kaibeckmann/EchtzeitHat/EchtzeitHat_Bestückungsliste.ods

Step | Part | Value | Device | Package
SMD 1 | C2 | 0.1uF | 1.0UF-25V-+80/-20(0805) | 0806-CAP
 | C3 | 0.1uF | 1.0UF-25V-+80/-20(0805) | 0807-CAP
 | C4 | 0.1uF | 1.0UF-25V-+80/-20(0805) | 0808-CAP
 | C5 | 0.1uF | 1.0UF-25V-+80/-20(0805) | 0809-CAP
 | C6 | 0.1uF | 1.0UF-25V-+80/-20(0805) | 0810-CAP
 | C9 | 0.1uF | 1.0UF-25V-+80/-20(0805) | 0813-CAP
 | C11 | 0.1uF | 1.0UF-25V-+80/-20(0805) | 0815-CAP
 | C12 | 0.1uF | 1.0UF-25V-+80/-20(0805) | 0816-CAP
 | C10 | 10uF | 1.0UF-25V-+80/-20(0805) | 0814-CAP
 | C7 | 47pF | 1.0UF-25V-+80/-20(0805) | 0811-CAP
 | C8 | 47pF | 1.0UF-25V-+80/-20(0805) | 0812-CAP
 | C1 | 4.7uF | 1.0UF-25V-+80/-20(0805) | 0805-CAP
SMD 2 | R1 | 22 | 0.22OHM-1/4W-1%(0805) | 805
 | R2 | 22 | 0.22OHM-1/4W-1%(0805) | 805
 | R5 | 1k | 0.22OHM-1/4W-1%(0805) | 805
 | R3 | 4.7k | 0.22OHM-1/4W-1%(0805) | 805
 | R12 | 4.7k | 0.22OHM-1/4W-1%(0805) | 805
 | R4 | 10k | 0.22OHM-1/4W-1%(0805) | 805
 | R7 | 10k | 0.22OHM-1/4W-1%(0805) | 805
 | R9 | 10k | 0.22OHM-1/4W-1%(0805) | 805
 | R8 | 10k | 0.22OHM-1/4W-1%(0805) | 805
 | R11 | 10k | 0.22OHM-1/4W-1%(0805) | 805
 | R15 | 10k | 0.22OHM-1/4W-1%(0805) | 805
 | R16 | 10k | 0.22OHM-1/4W-1%(0805) | 805
 | R17 | 10k | 0.22OHM-1/4W-1%(0805) | 805
 | R18 | 10k | 0.22OHM-1/4W-1%(0805) | 805
 | R19 | 10k | 0.22OHM-1/4W-1%(0805) | 805
 | R6 | 1.5k | 0.22OHM-1/4W-1%(0805) | 805
 | R10 | 1.5k | 0.22OHM-1/4W-1%(0805) | 805
 | R13 | 1.5k | 0.22OHM-1/4W-1%(0805) | 805
 | R14 | 1.5k | 0.22OHM-1/4W-1%(0805) | 805
SMD 3 | LED1 | green | LEDCHIPLED_0805 | CHIPLED_0805
 | LED2 | green | LEDCHIPLED_0805 | CHIPLED_0805
 | LED3 | green | LEDCHIPLED_0805 | CHIPLED_0805
 | LED4 | green | LEDCHIPLED_0805 | CHIPLED_0805
SMD 4 | Q1 | L2N7002LT1G | MOSFET-NREFLOW | SOT23
 | Q2 | L2N7002LT1G | MOSFET-NREFLOW | SOT23
 | Q3 | L2N7002LT1G | MOSFET-NREFLOW | SOT23
 | Q4 | L2N7002LT1G | MOSFET-NREFLOW | SOT23
 | Q5 | L2N7002LT1G | MOSFET-NREFLOW | SOT23
SMD5 | U1 | FT230XS-R | FT230XS-R | SSOP16-0.635-5X4MM
 | IC2 | TB6612FNG | TB6612FNG | SSOP24
 | IC3 | ATTINY10 | ATTINY10 | SOT23-6
 | CON1 | MICRO-USB | Molex Micro-USB 47589-0001 | 47589-0001
TH 1 | X1 | RasbPi-Header | RASPI_BOARD_B+#_H | RASPI_BOARD_B+HAT
TH 2 | SW1 | TACTILE-SWITCH-PTH | TACTILE-SWITCH-PTH | TAC-SWITCH-PTH
 | SW2 | TACTILE-SWITCH-PTH | TACTILE-SWITCH-PTH | TAC-SWITCH-PTH
TH 3 | J1 | UART | CONN_03LOCK | 1X03_LOCK
 | J3 |  | CONN_03LOCK | 1X03_LOCK
 | J4 |  | CONN_03LOCK | 1X03_LOCK
 | J6 |  | CONN_03LOCK | 1X03_LOCK
 | J7 |  | CONN_03LOCK | 1X03_LOCK
 | J8 |  | M03LOCK | 1X03_LOCK
 | J11 |  | CONN_03LOCK | 1X03_LOCK
 | J12 |  | CONN_03LOCK | 1X03_LOCK
 | J13 | TPI | CONN_05LOCK | 1X05_LOCK
 | J14 | Voltage Out | M04LOCK | 1X04_LOCK
TH 4 | J9 |  | M023.5MM_LOCK | SCREWTERMINAL-3.5MM
 | J10 |  | M023.5MM_LOCK | SCREWTERMINAL-3.5MM
TH 5 | J5 | FAN 4-pin Header | MOLEX_47053-1000 | MOLEX_47053-1000_0
TH 6 | IC1 | VREG-OKI-78SR-5.0 | VREG-OKI-78SR-5.0/1.5-W36H | OKI-78SR-H
TH 7 | J2 | PJ-102A | PJ-102A | CUI_PJ-102A
TH 8 | VR1 | 10k | POTENTIOMETER-PTH-9MM | POT-PTH-ALPS-KIT
