kaibeckmann/EchtzeitHat/schematic/EchtzeitHat_sch.pdf

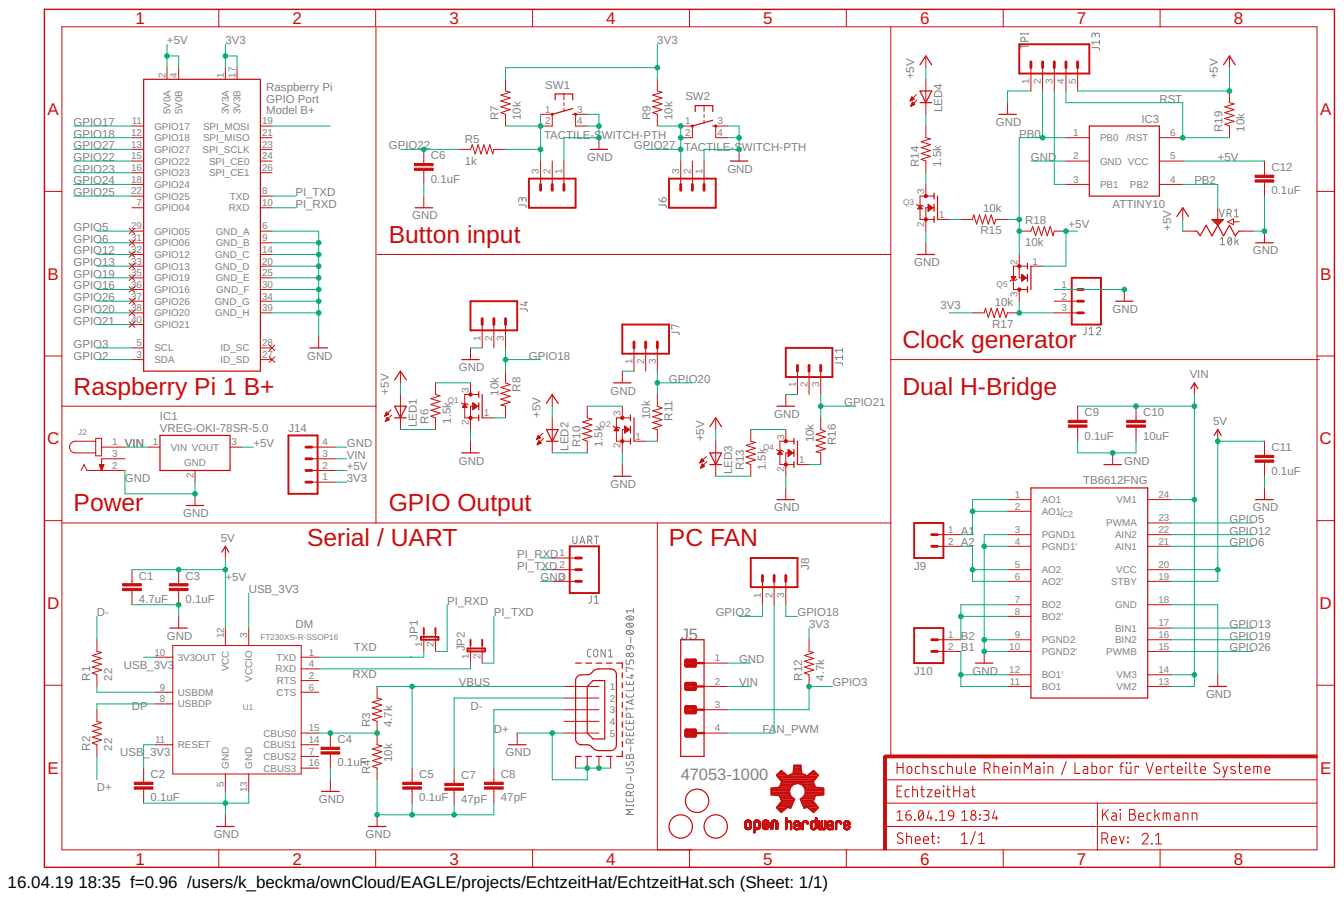
[picture p1: page 1]

17 GND

16 BIN1 | GPIO19
15 BIN2 | GPIO26
14 PWMB

16.04.19 18:35 f=0.96 /users/k_beckma/ownCloud/EAGLE/projects/EchtzeitHat/EchtzeitHat.sch (Sheet: 1/1)
