kaibeckmann/EchtzeitHat/schematic/EchtzeitHat_brd.pdf

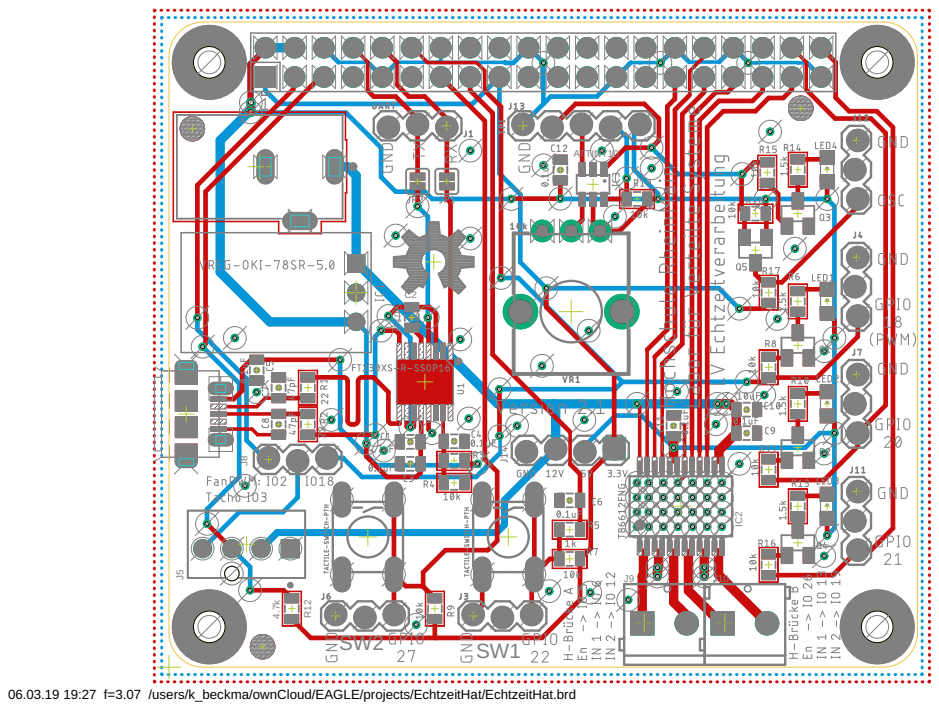
[picture p2: page 1]

06.03.19 19:27 f=3.07 /users/k_beckma/ownCloud/EAGLE/projects/EchtzeitHat/EchtzeitHat.brd
