kaibeckmann/EchtzeitHat/schematic/EchtzeitHat.brd

## EAGLE design schematic/EchtzeitHat.brd (2020-04-17)

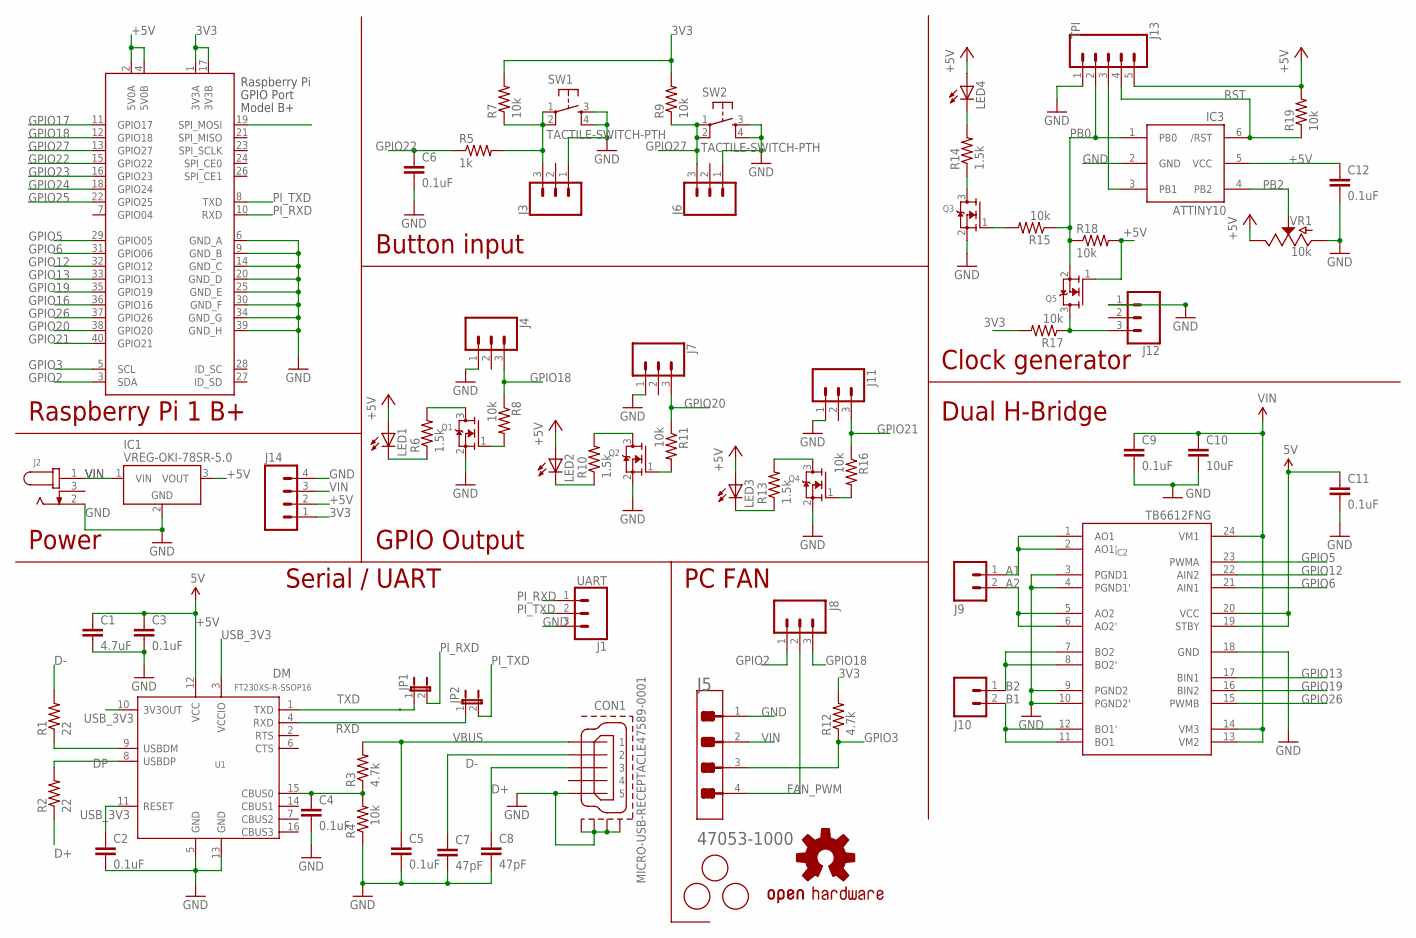
[picture p3: schematic EchtzeitHat.sch]

Parts:
C1: 4.7uF; 0805-CAP
C2, C3, C4, C5, C6, C9, C11, C12: 0.1uF; 0805-CAP
C7, C8: 47pF; 0805-CAP
C10: 10uF; 0805-CAP
CON1: MICRO-USB-RECEPTACLE47589-0001; 47589-0001
FI1, FI2, FI3: FIDUCIAL; FIDUCIAL_1MM
IC1: VREG-OKI-78SR-5.0; OKI-78SR-H
IC2: TB6612FNG; SSOP24
IC3: ATTINY10; SOT23-6
J1: UART; 1X03_LOCK
J2: PJ-102A; CUI_PJ-102A
J3, J4, J6, J7, J11, J12: CONN_03LOCK; 1X03_LOCK
J5: MOLEX_47053-1000MOLEX_47053-1000_0_0; MOLEX_47053-1000_0
J8: M03LOCK; 1X03_LOCK
J9, J10: M023.5MM_LOCK; SCREWTERMINAL-3.5MM-2_LOCK
J13: TPI; 1X05_LOCK
J14: M04LOCK; 1X04_LOCK
JP1, JP2: JUMPER-2SMD-NC; SJ_2S
LED1, LED2, LED3, LED4: LEDCHIPLED_0805; CHIPLED_0805
LOGO1: OSHW-LOGOL; OSHW-LOGO-L
Q1, Q2, Q3, Q4, Q5: MOSFET-NREFLOW; SOT23
R1, R2: 22; 0805
R3, R12: 4.7k; 0805
R4, R7, R8, R9, R11, R15, R16, R17, R18, R19: 10k; 0805
R5: 1k; 0805
R6, R10, R13, R14: 1.5k; 0805
SW1, SW2: TACTILE-SWITCH-PTH; TAC-SWITCH-PTH
U1: FT230XS-R-SSOP16; SSOP16-0.635-5X4MM
VR1: 10k; POT-PTH-ALPS-KIT
X1: RASPI_BOARD_B+#_H; RASPI_BOARD_B+HAT

Connections:
3V3: J14.1, R7.2, R9.2, R12.2, R17.2, X1.1 (3V3A), X1.17 (3V3B)
+5V: C1.1, C3.1, C11.1, C12.1, IC1.3 (VOUT), IC2.19 (STBY), IC2.20 (VCC), IC3.5 (VCC), J13.5, J14.2, LED1.A, LED2.A, LED3.A, LED4.A, Q5.1 (G), R18.2, R19.2, U1.12 (VCC), VR1.P$1 (E), X1.2 (5V0A), X1.4 (5V0B)
A1: IC2.1 (AO1), IC2.2 (AO1'), J9.1
A2: IC2.5 (AO2), IC2.6 (AO2'), J9.2
B1: IC2.11 (BO1), IC2.12 (BO1'), J10.2
B2: IC2.7 (BO2), IC2.8 (BO2'), J10.1
CBUS: C4.1, R3.1, R4.2, U1.15 (CBUS0)
D+: C8.1, CON1.3, R2.1
D-: C7.1, CON1.2, R1.2
DM: R1.1, U1.9 (USBDM)
DP: R2.2, U1.8 (USBDP)
FAN_PWM: J5.4, J8.2
GND: C1.2, C2.2, C3.2, C4.2, C5.2, C6.2, C7.2, C8.2, C9.2, C10.2, C11.2, C12.2, CON1.5, CON1.CASING1 (GND1), CON1.CASING2 (GND2), CON1.CASING3 (GND3), CON1.CASING4 (GND4), IC1.2 (GND), IC2.3 (PGND1), IC2.4 (PGND1'), IC2.9 (PGND2), IC2.10 (PGND2'), IC2.18 (GND), IC3.2 (GND), J1.3, J2.2, J3.1, J4.1, J5.1, J6.1, J7.1, J11.1, J12.1, J13.1, J14.4, Q1.2 (S), Q2.2 (S), Q3.2 (S), Q4.2 (S), R4.1, SW1.3, SW1.4, SW2.3, SW2.4, U1.5 (GND), U1.13 (GND), VR1.P$3 (A), X1.6 (GND_A), X1.9 (GND_B), X1.14 (GND_C), X1.20 (GND_D), X1.25 (GND_E), X1.30 (GND_F), X1.34 (GND_G), X1.39 (GND_H)
GPIO2: J8.1, X1.3 (SDA)
GPIO3: J5.3, R12.1, X1.5 (SCL)
GPIO5: IC2.23 (PWMA), X1.29 (GPIO05)
GPIO6: IC2.21 (AIN1), X1.31 (GPIO06)
GPIO12: IC2.22 (AIN2), X1.32 (GPIO12)
GPIO13: IC2.17 (BIN1), X1.33 (GPIO13)
GPIO16: X1.36 (GPIO16)
GPIO17: X1.11 (GPIO17)
GPIO18: J4.3, J8.3, R8.1, X1.12 (GPIO18)
GPIO19: IC2.16 (BIN2), X1.35 (GPIO19)
GPIO20: J7.3, R11.1, X1.38 (GPIO20)
GPIO21: J11.3, R16.1, X1.40 (GPIO21)
GPIO22: C6.1, R5.1, X1.15 (GPIO22)
GPIO23: X1.16 (GPIO23)
GPIO24: X1.18 (GPIO24)
GPIO25: X1.22 (GPIO25)
GPIO26: IC2.15 (PWMB), X1.37 (GPIO26)
GPIO27: J6.3, R9.1, SW2.1, SW2.2, X1.13 (GPIO27)
unnamed: LED1.C, R6.1
unnamed: IC3.3 (PB1), J13.3
unnamed: Q1.3 (D), R6.2
unnamed: Q1.1 (G), R8.2
unnamed: LED4.C, R14.2
unnamed: Q3.3 (D), R14.1
unnamed: Q3.1 (G), R15.2
unnamed: J3.3, R5.2, R7.1, SW1.1, SW1.2
unnamed: LED2.C, R10.1
unnamed: Q2.3 (D), R10.2
unnamed: Q2.1 (G), R11.2
unnamed: LED3.C, R13.1
unnamed: Q4.3 (D), R13.2
unnamed: Q4.1 (G), R16.2
OSC: J12.3, Q5.3 (D), R17.1
PB0: IC3.1 (PB0), J13.2, Q5.2 (S), R15.1, R18.1
PB2: IC3.4 (PB2), VR1.P$2 (S)
PI_RXD: J1.1, JP1.2, X1.10 (RXD)
PI_TXD: J1.2, JP2.2, X1.8 (TXD)
RST: IC3.6 (/RST), J13.4, R19.1
RXD: JP2.1, U1.4 (RXD)
TXD: JP1.1, U1.1 (TXD)
USB_3V3: C2.1, U1.3 (VCCIO), U1.10 (3V3OUT), U1.11 (RESET)
VBUS: C5.1, CON1.1, R3.2
VIN: C9.1, C10.1, IC1.1 (VIN), IC2.13 (VM2), IC2.14 (VM3), IC2.24 (VM1), J2.1, J5.2, J14.3

Notes on the sheet:
Serial / UART
PC FAN
Power
Raspberry Pi 1 B+
Dual H-Bridge
Clock generator
Button input
GPIO Output

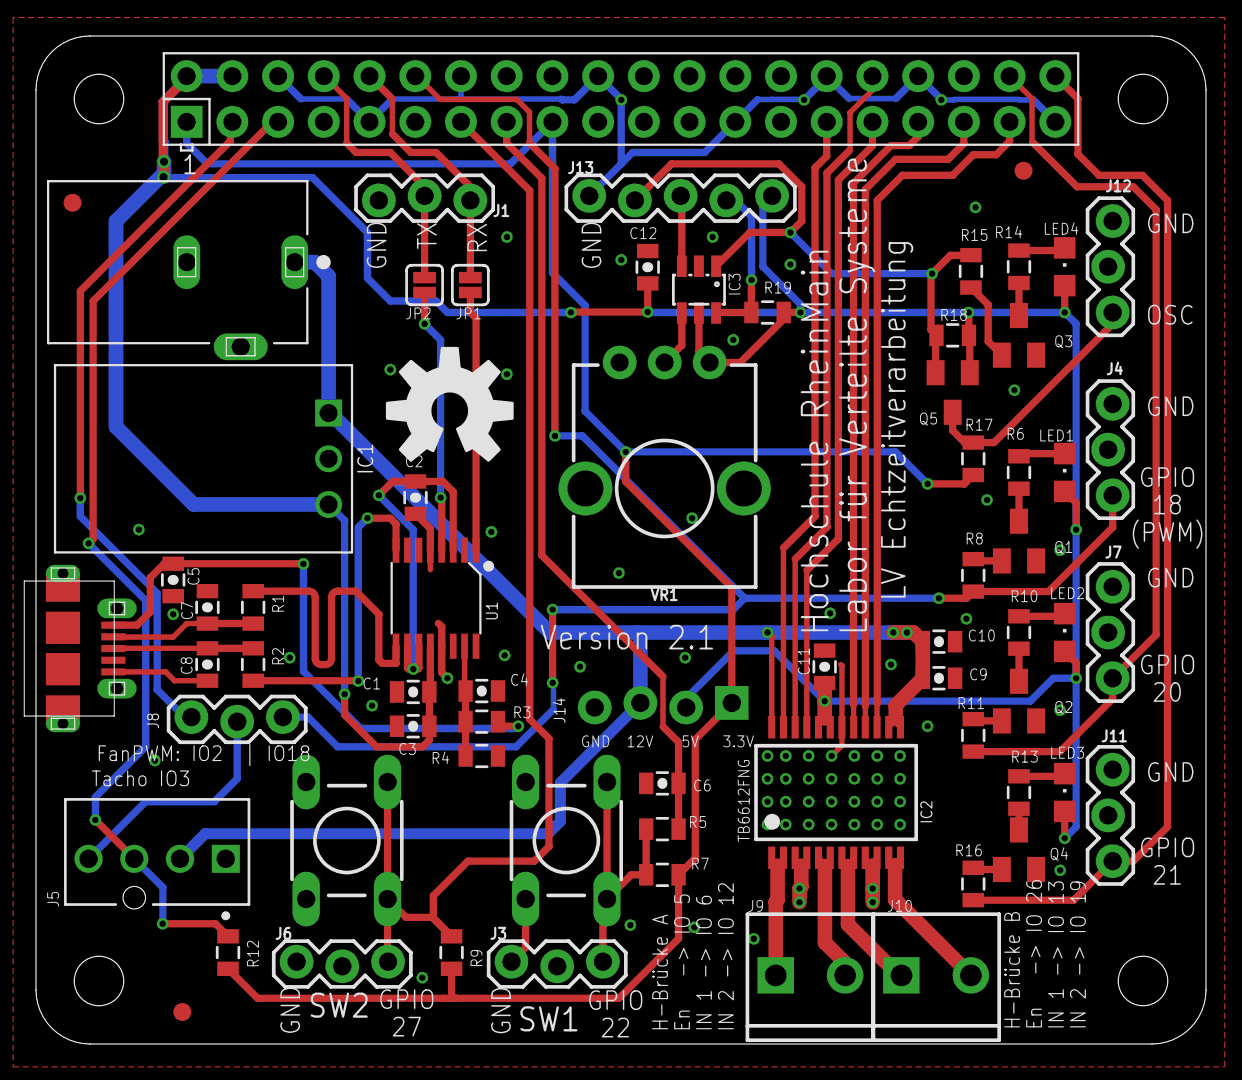
[picture p4: board EchtzeitHat.brd from above]

Board: 2 copper layers, 65.0 x 56.0 mm, 69 parts (1 on the bottom side), 51 nets.
